minhultimatealien/soccer_robot/Document/Image/Reference/Robocup2018_humanoid final.jpg

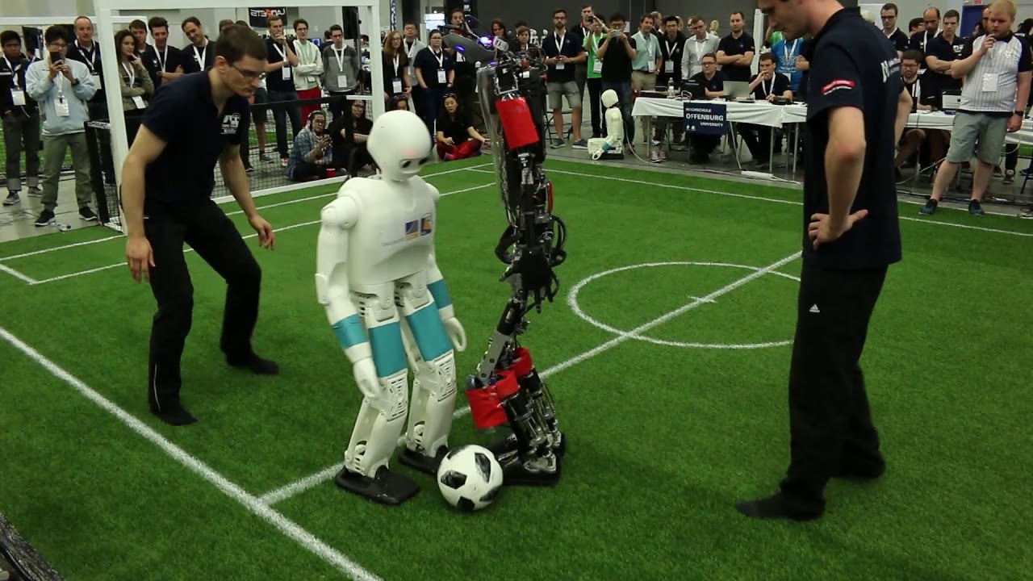
Document/Image/Reference/Robocup2018_humanoid final.jpg
