minhultimatealien/soccer_robot/Document/Image/Pilot/z7851552882575_aa248686b74a95beae13a69e27333dba.jpg

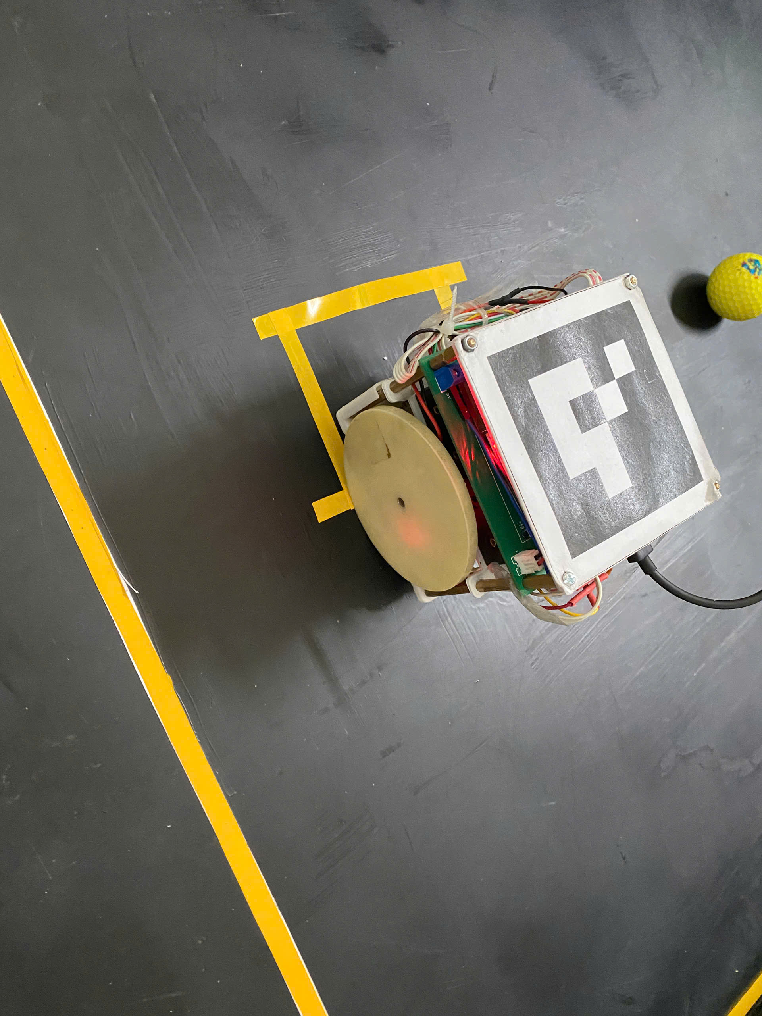
Document/Image/Pilot/z7851552882575_aa248686b74a95beae13a69e27333dba.jpg
