minhultimatealien/soccer_robot/Document/Image/Reference/20210513_170346-2.png

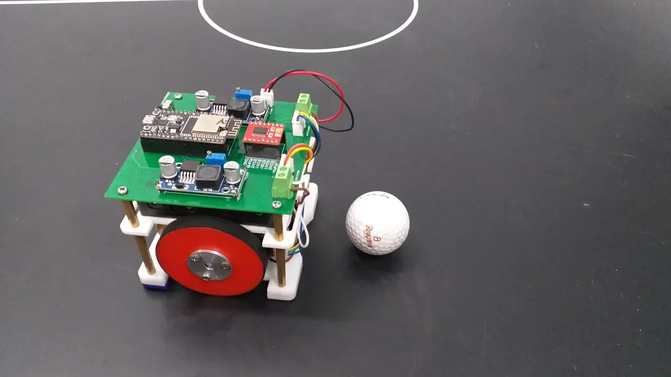
Document/Image/Reference/20210513_170346-2.png
