minhultimatealien/soccer_robot/Document/Image/Reference/Ball Dribbling control.jpg

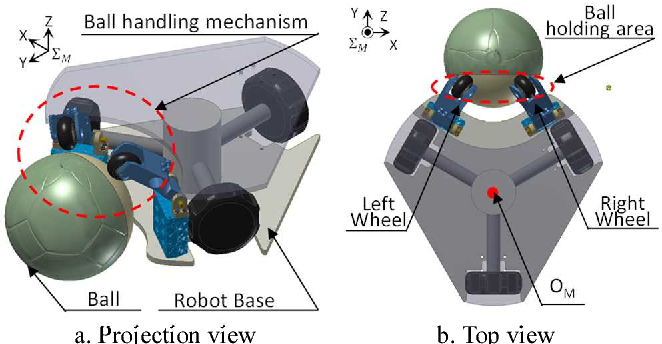
Document/Image/Reference/Ball Dribbling control.jpg
