minhultimatealien/soccer_robot/Document/Image/Reference/beat_worldcup.jpg

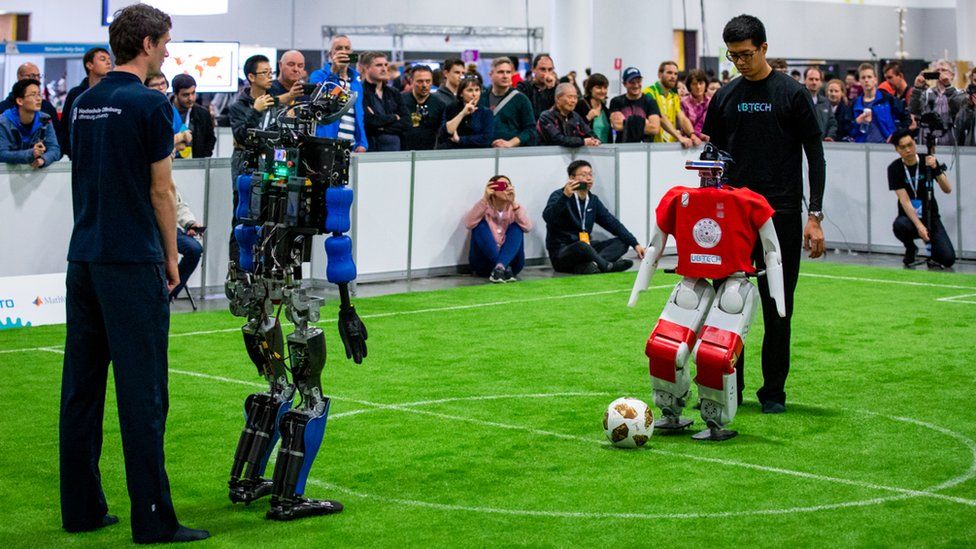
Document/Image/Reference/beat_worldcup.jpg
