minhultimatealien/soccer_robot/Document/Image/Reference/HSV_color_solid_cylinder.png

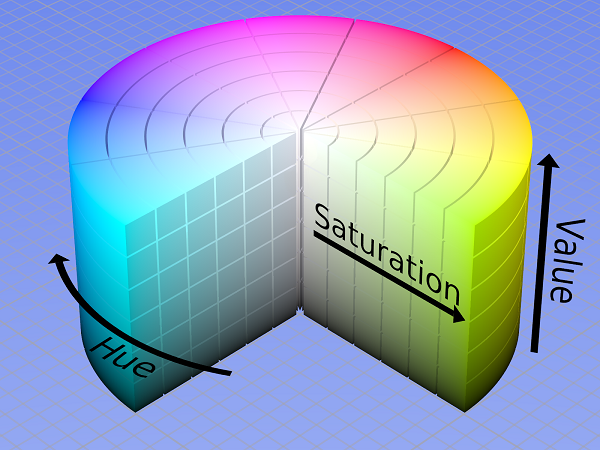
Document/Image/Reference/HSV_color_solid_cylinder.png
