minhultimatealien/soccer_robot/Document/Image/Reference/Kid_size_humanoid.jpg

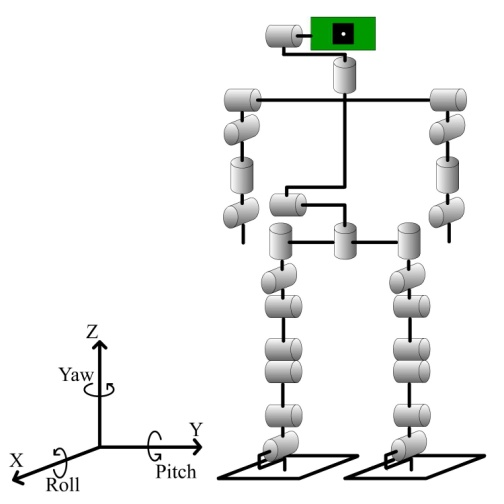
Document/Image/Reference/Kid_size_humanoid.jpg
