minhultimatealien/soccer_robot/Document/Image/Reference/Kidsize_humanoid_league.jpg

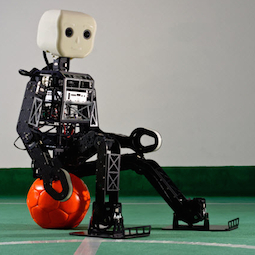
Document/Image/Reference/Kidsize_humanoid_league.jpg
