minhultimatealien/soccer_robot/Document/Image/Reference/machines-08-00029-g007.png

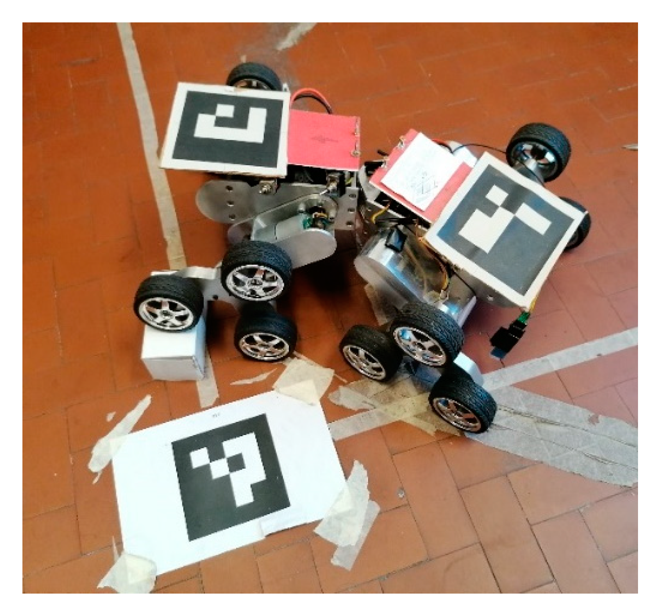
Document/Image/Reference/machines-08-00029-g007.png
