minhultimatealien/soccer_robot/Document/Image/Reference/middle_size_leauge.jpg

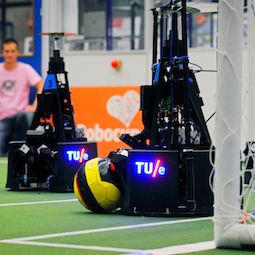
Document/Image/Reference/middle_size_leauge.jpg
