minhultimatealien/soccer_robot/Document/Image/Reference/Omni-Directional Drive.jpg

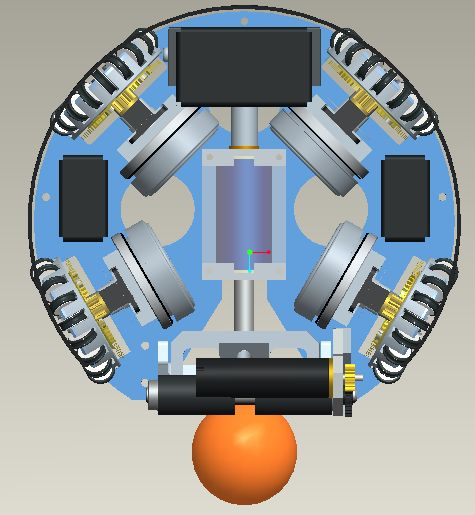
Document/Image/Reference/Omni-Directional Drive.jpg
