minhultimatealien/soccer_robot/Document/Image/Reference/peter stone.jpg

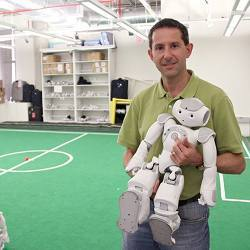
Document/Image/Reference/peter stone.jpg
