minhultimatealien/soccer_robot/Document/Image/Reference/pict1.jpg

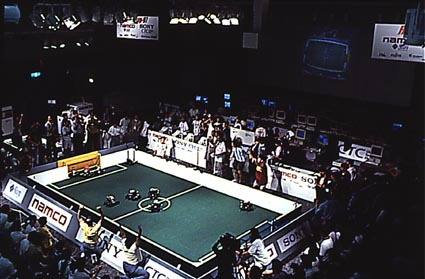
Document/Image/Reference/pict1.jpg
