minhultimatealien/soccer_robot/Document/Image/Reference/Picture1.png

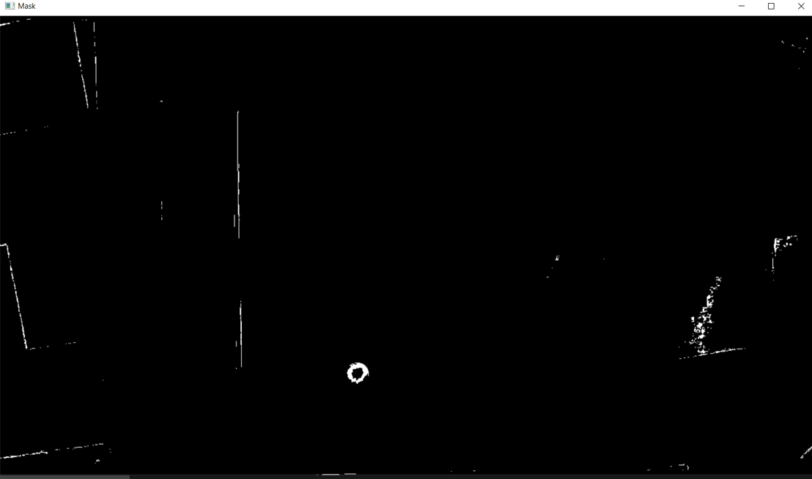
Document/Image/Reference/Picture1.png
