minhultimatealien/soccer_robot/Document/Image/Reference/rescue_robot_league.jpg

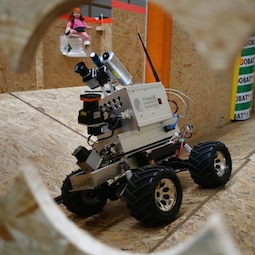
Document/Image/Reference/rescue_robot_league.jpg
