minhultimatealien/soccer_robot/Document/Image/Reference/small_size_league.jpg

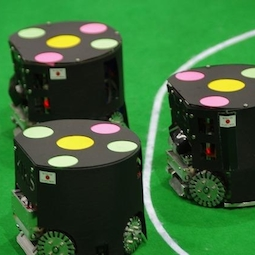
Document/Image/Reference/small_size_league.jpg
