minhultimatealien/soccer_robot/Document/Image/Reference/soccer-robot-system-drawing.png

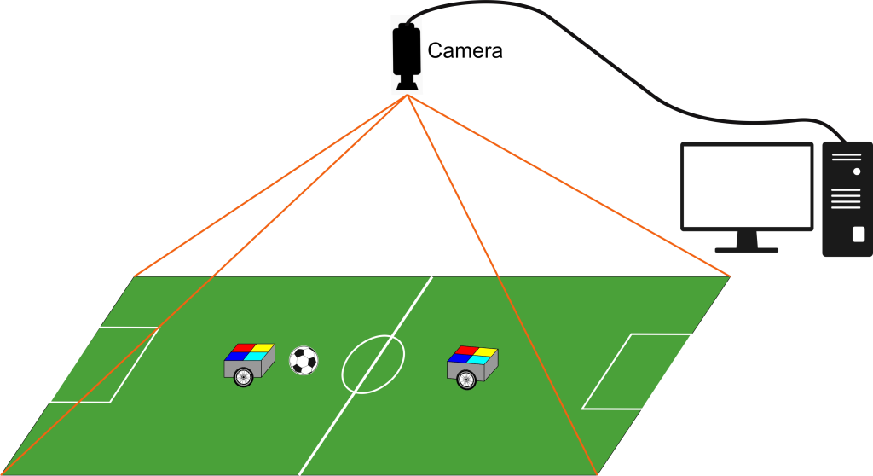
Document/Image/Reference/soccer-robot-system-drawing.png
