minhultimatealien/soccer_robot/Document/Image/Reference/Some-of-the-RoboCup-2006-Humanoid-League-robots.png

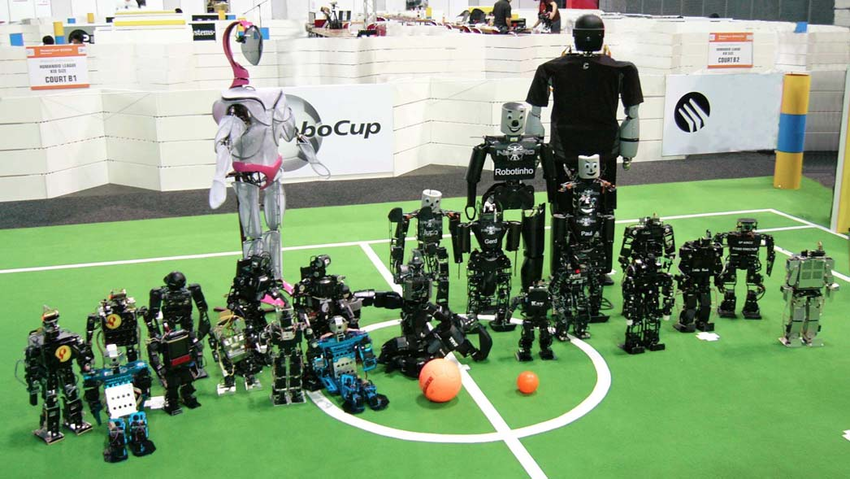
Document/Image/Reference/Some-of-the-RoboCup-2006-Humanoid-League-robots.png
