minhultimatealien/soccer_robot/Document/Image/Reference/The-RoboRoos-kicker-mechanism-In-the-figure-the-striker-is-shown-locked-in-soft-kick.jpg

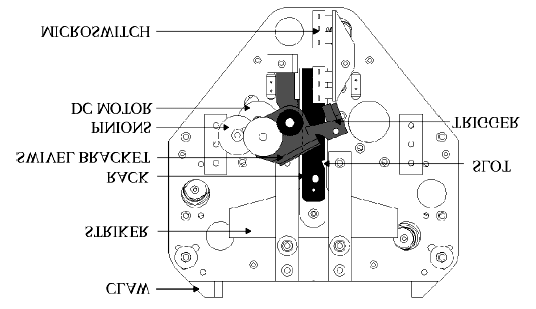
Document/Image/Reference/The-RoboRoos-kicker-mechanism-In-the-figure-the-striker-is-shown-locked-in-soft-kick.jpg
