minhultimatealien/soccer_robot/(list of files, cad)

Other CAD files:
Document/Main document/Principle-selection.dwg
