minhultimatealien/soccer_robot/Document/Main document/Drivengear_fabrication.pdf

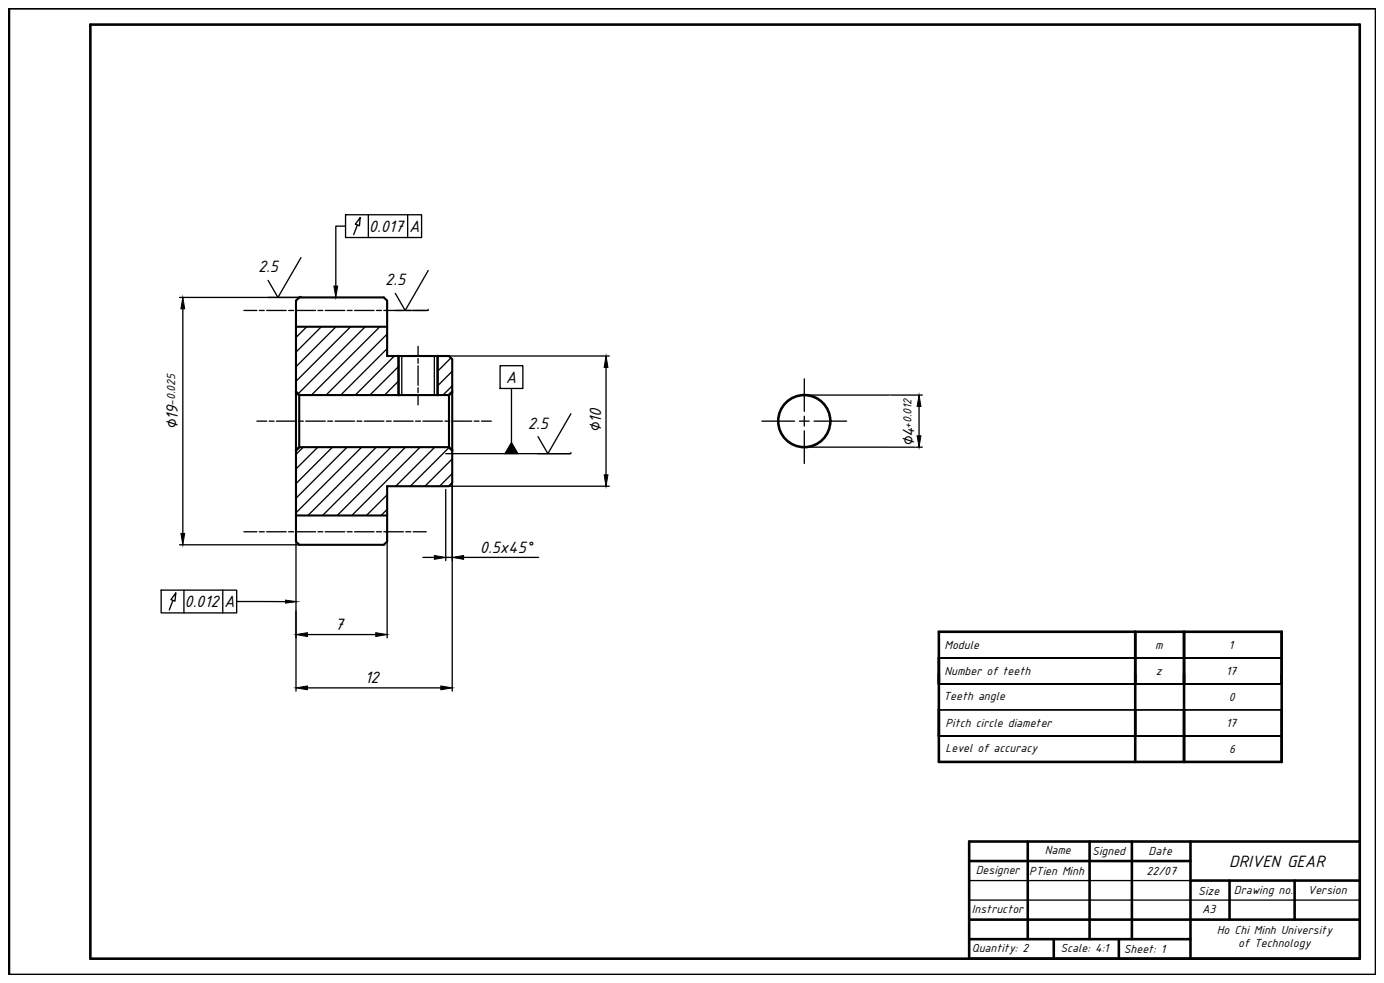
[picture p134: page 1]

∅4+0.012 Number of teeth z 17 Teeth angle 0 Module m 1 Level of accuracy 6 Pitch circle diameter 17 Name Signed Date Designer Instructor Size Drawing no. Version A3 Quantity: 2 Scale: 4:1 Sheet: 1 PTien Minh DRIVEN GEAR Ho Chi Minh University of Technology 22/07
