minhultimatealien/soccer_robot/Document/Main document/Drivinggear_fabrication.pdf

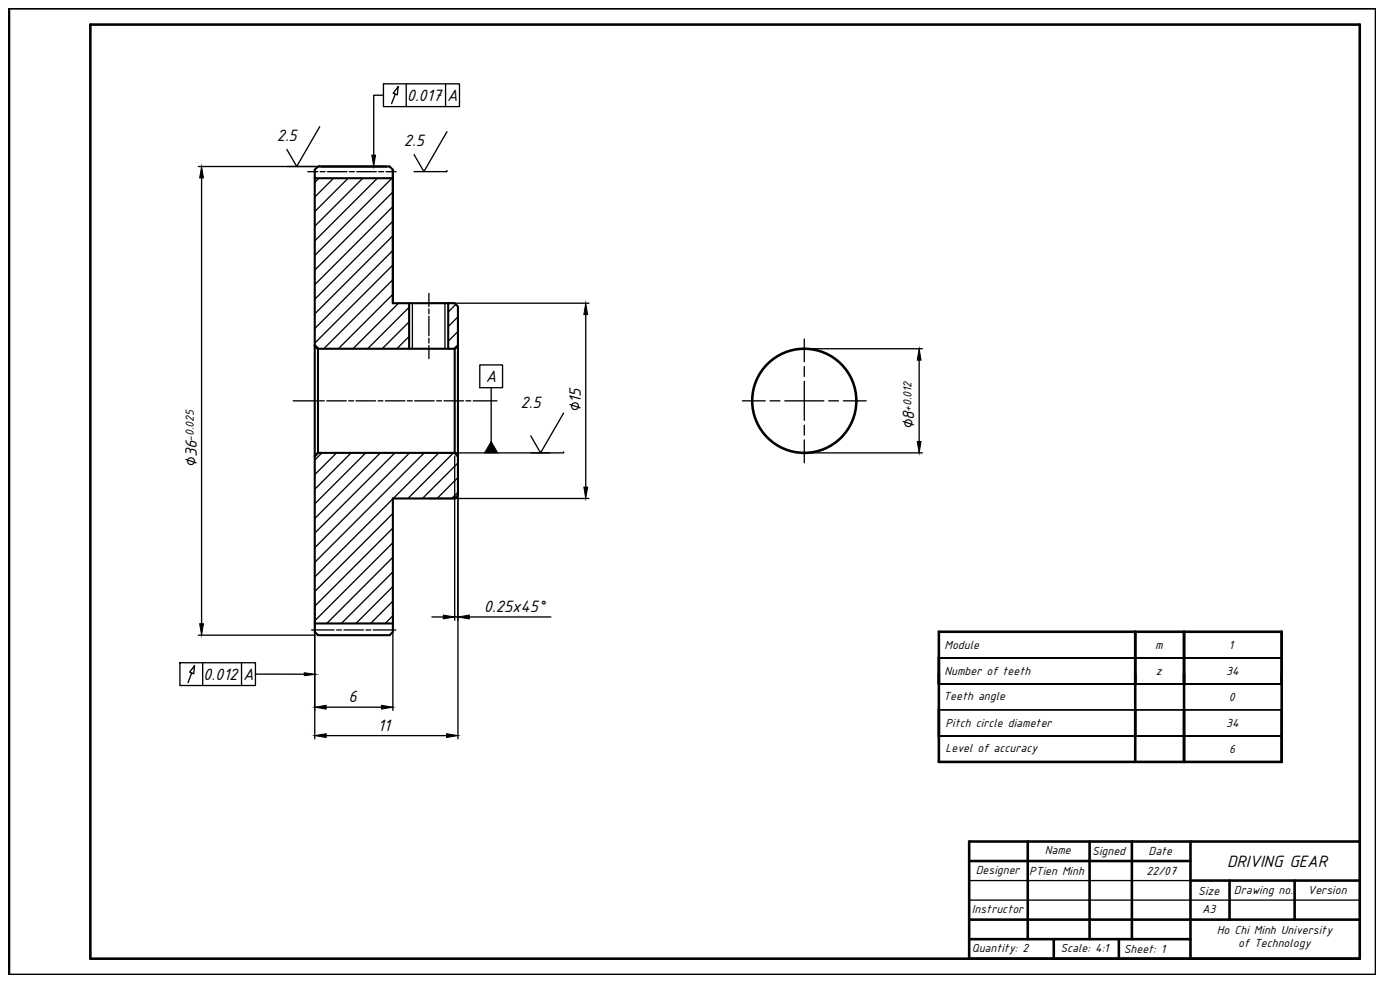
[picture p135: page 1]

∅15 A 2.5 0.017 A 2.5 2.5 Name Signed Date Designer Instructor Size Drawing no. Version A3 Quantity: 2 Scale: 4:1 Sheet: 1 PTien Minh DRIVING GEAR Ho Chi Minh University of Technology 22/07

∅8+0.012 Number of teeth z 34 Teeth angle 0 Module m 1 Level of accuracy 6 Pitch circle diameter 34
