minhultimatealien/soccer_robot/Document/Main document/Mechanical-deisgn.pdf

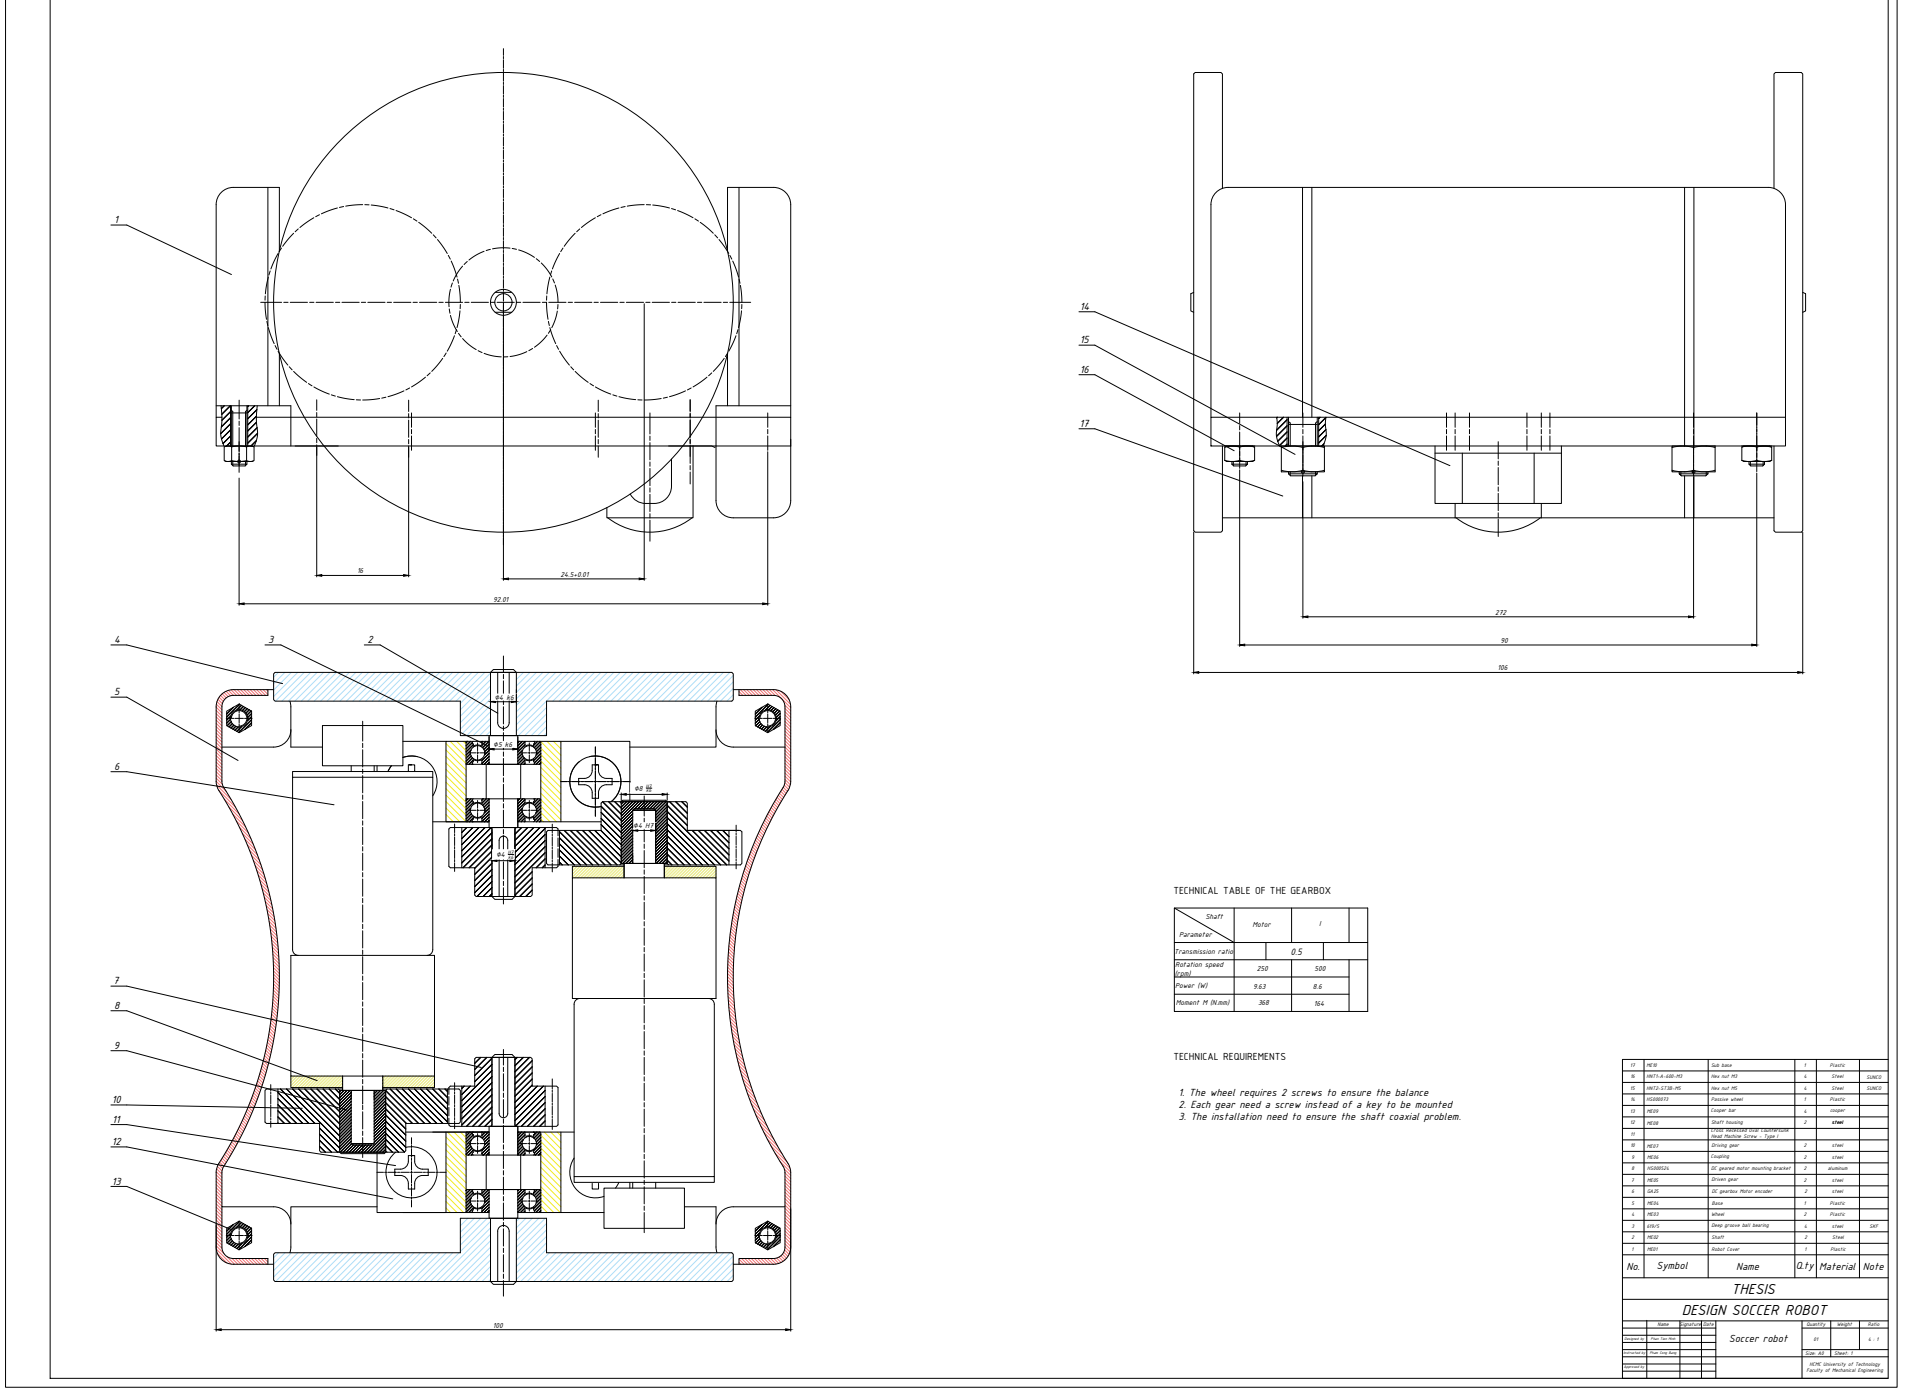
[picture p136: page 1]
Shaft Parameter; Motor; I Transmission ratio Rotation speed (rpm) Power (W); 8.6 TECHNICAL TABLE OF THE GEARBOX 0.5 Moment M (N.mm); 164 TECHNICAL REQUIREMENTS 1. The wheel requires 2 screws to ensure the balance 2. Each gear need a screw instead of a key to be mounted 3. The installation need to ensure the shaft coaxial problem.; THESIS DESIGN SOCCER ROBOT Soccer robot; Quantity; Weight; Ratio 01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
