minhultimatealien/soccer_robot/Document/Main document/Mechanical-design.pdf

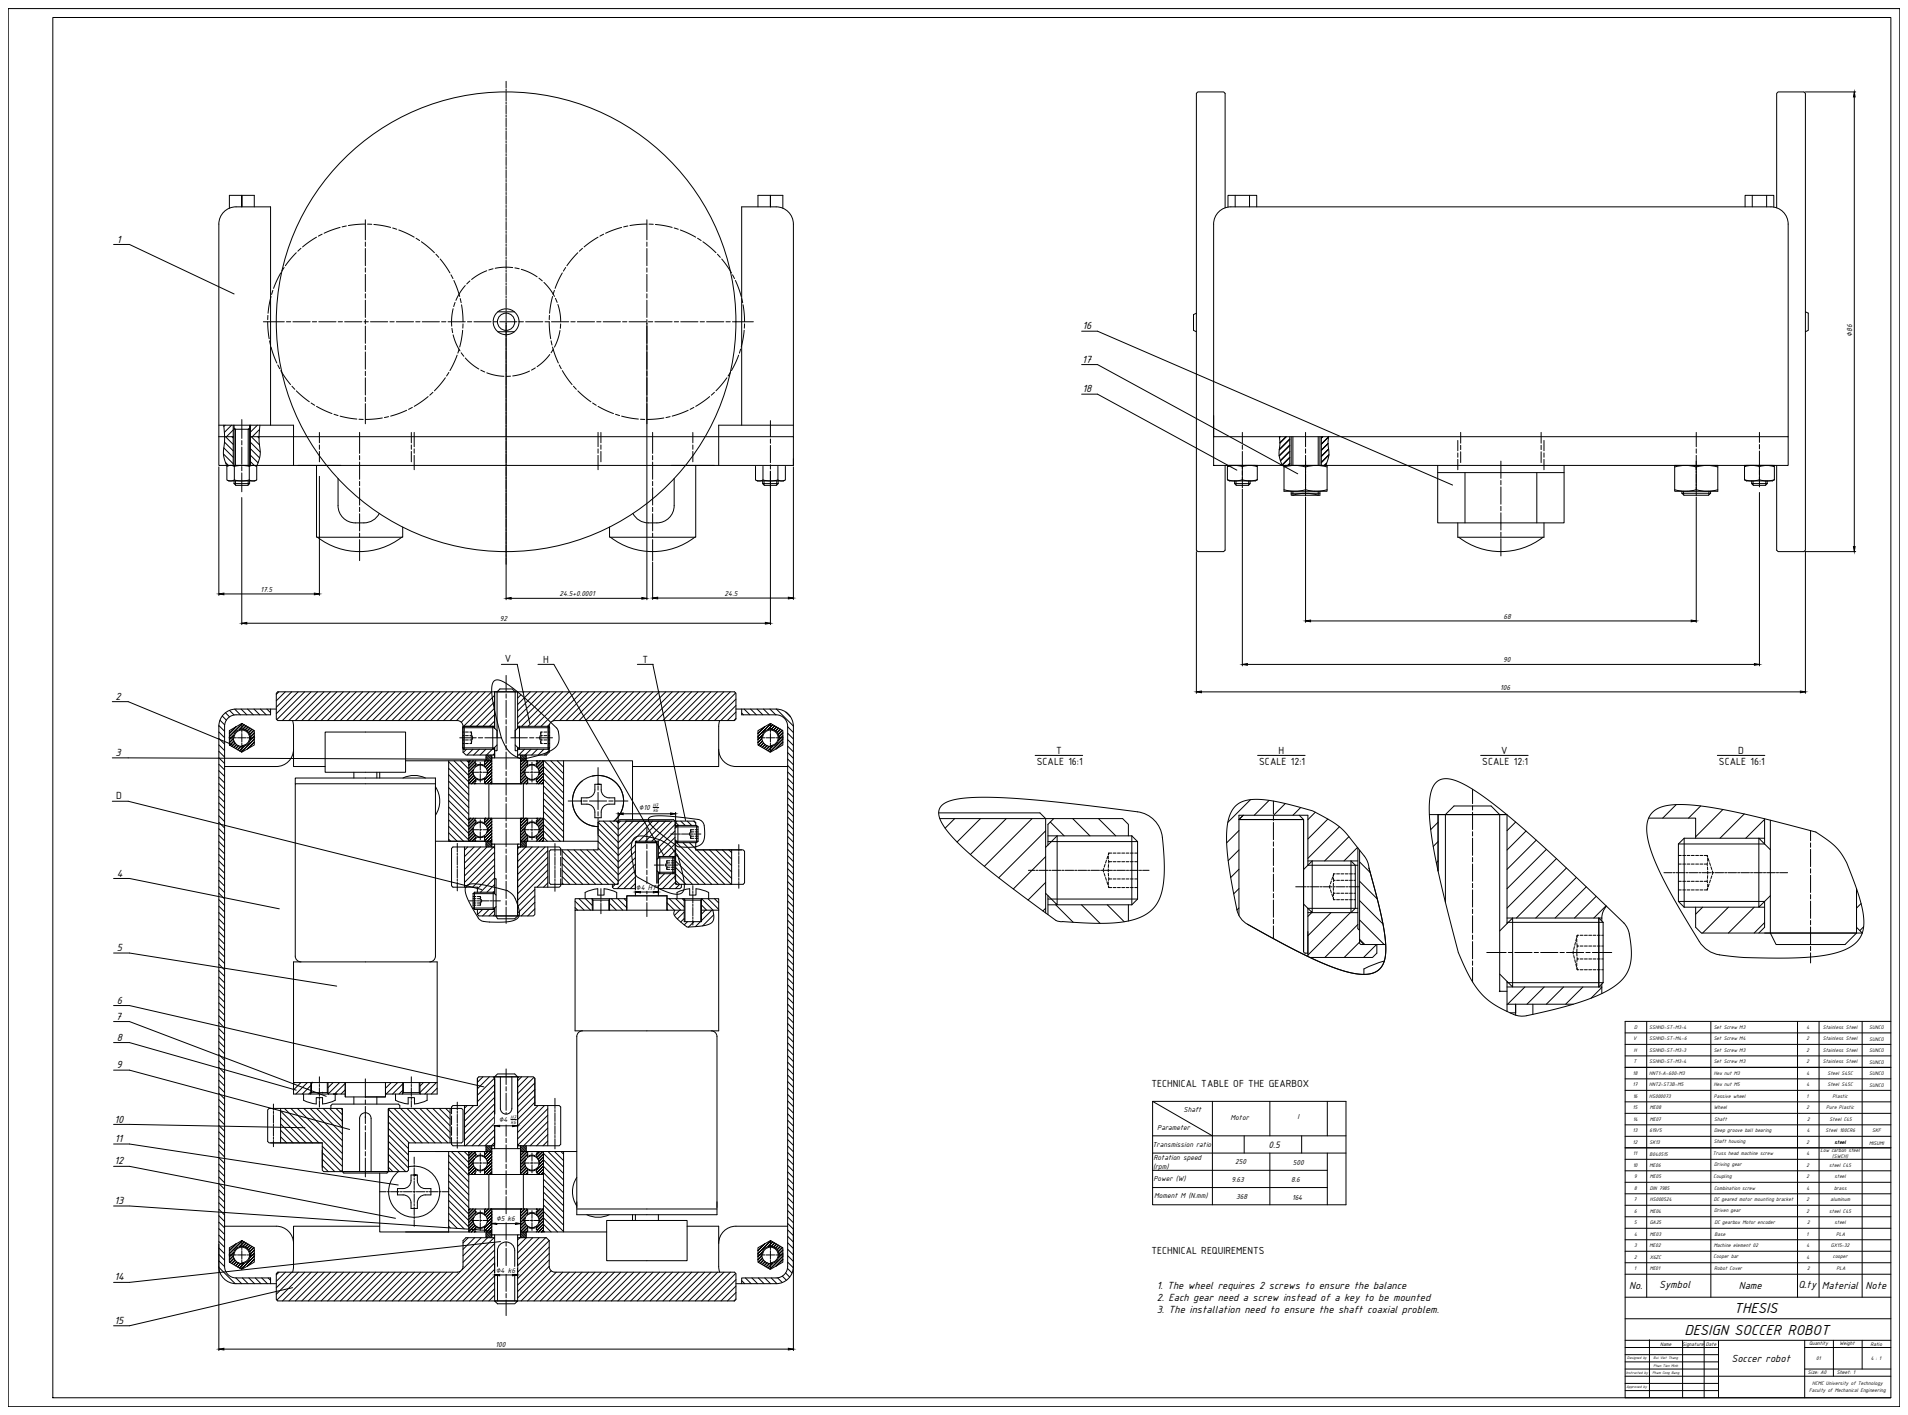
[picture p137: page 1]

∅86 3 3 ME02 Machine element 02 4 GX15-32 12D 8 DIN 7985 Combination screw 4 brass B040515 Truss head machine screw Low carbon steel (SWCH) Stainless Steel Stainless Steel Stainless Steel Steel S45C 24.5 X6ZC SK13 MISUMI Phan Tien Minh
