minhultimatealien/soccer_robot/Document/Main document/Shaft_fabrication.pdf

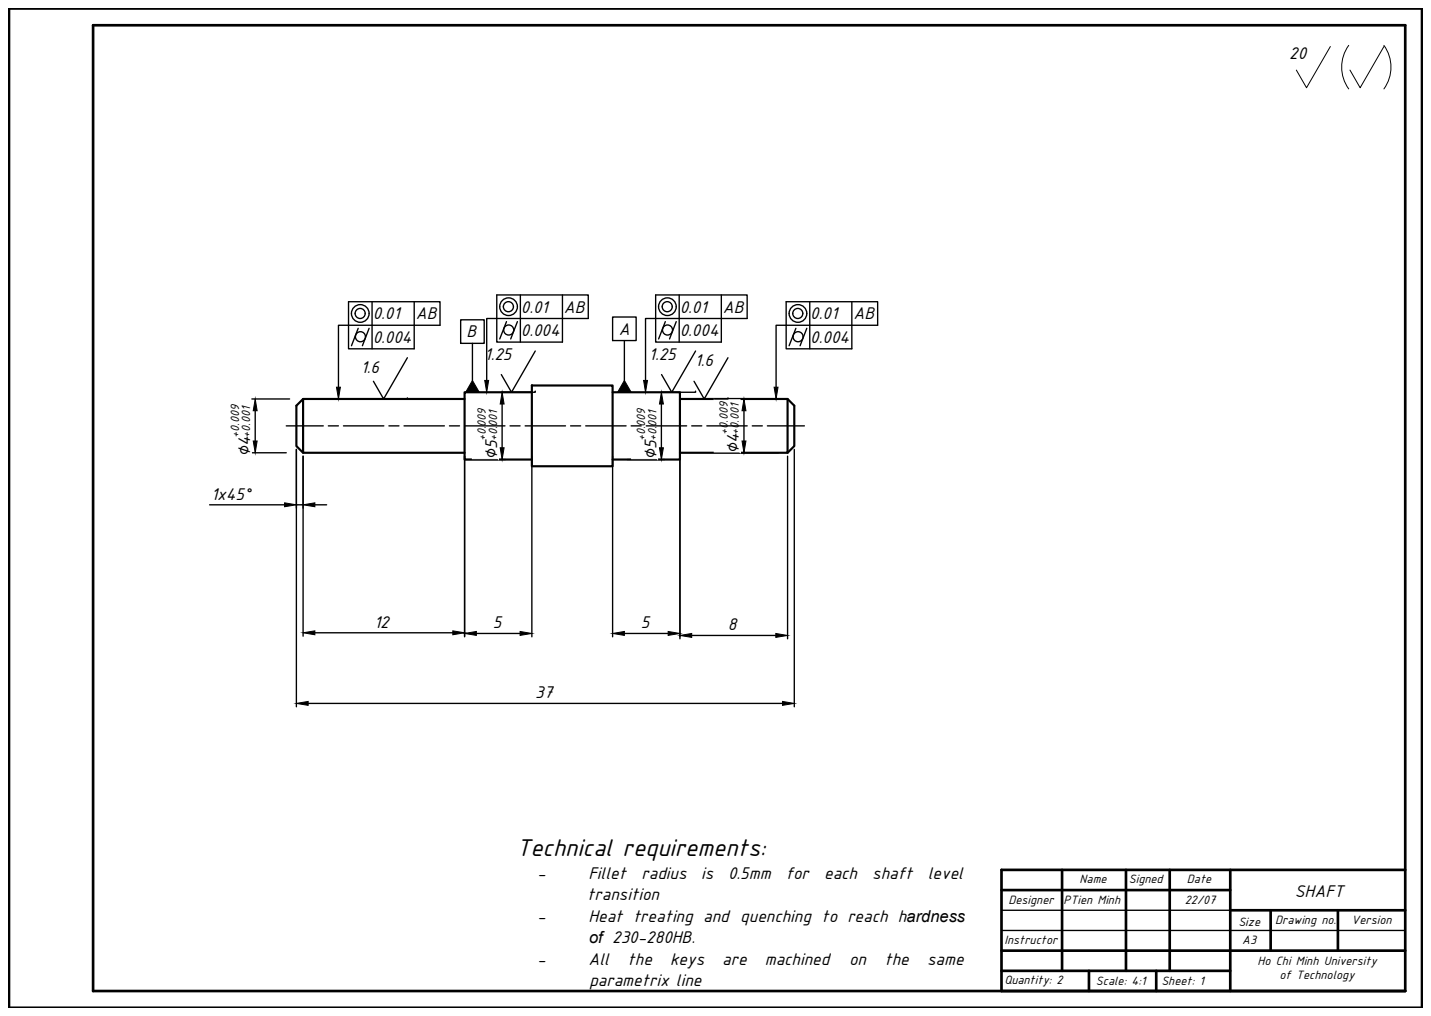
[picture p138: page 1]

+0.001 1x45° 1.6 1.6 1.25 1.25 20 Name Signed Date Designer Instructor Size Drawing no. Version A3 Quantity: 2 Scale: 4:1 Sheet: 1 PTien Minh SHAFT Ho Chi Minh University of Technology 22/07 Technical requirements: - Fillet radius is 0.5mm for each shaft level transition - Heat treating and quenching to reach hardness of 230-280HB. - All the keys are machined on the same parametrix line
