minhultimatealien/soccer_robot/Document/Main document/Figure_driver_block.pdf

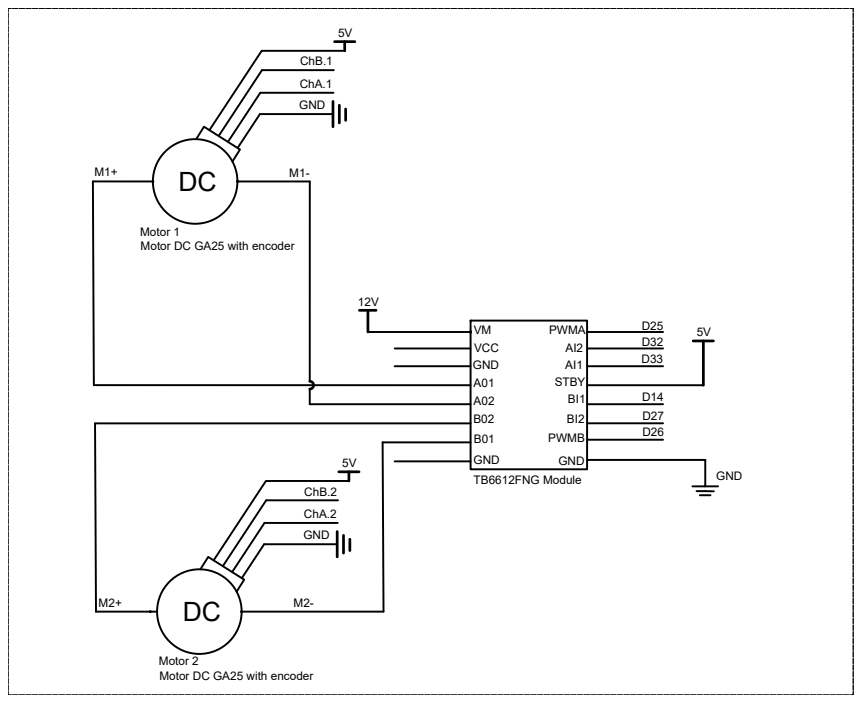
[picture p139: page 1]
TB6612FNG Module

Motor 1
Motor DC GA25 with encoder

Motor 2
