minhultimatealien/soccer_robot/Document/Main document/Robot_control_algorithm.pdf

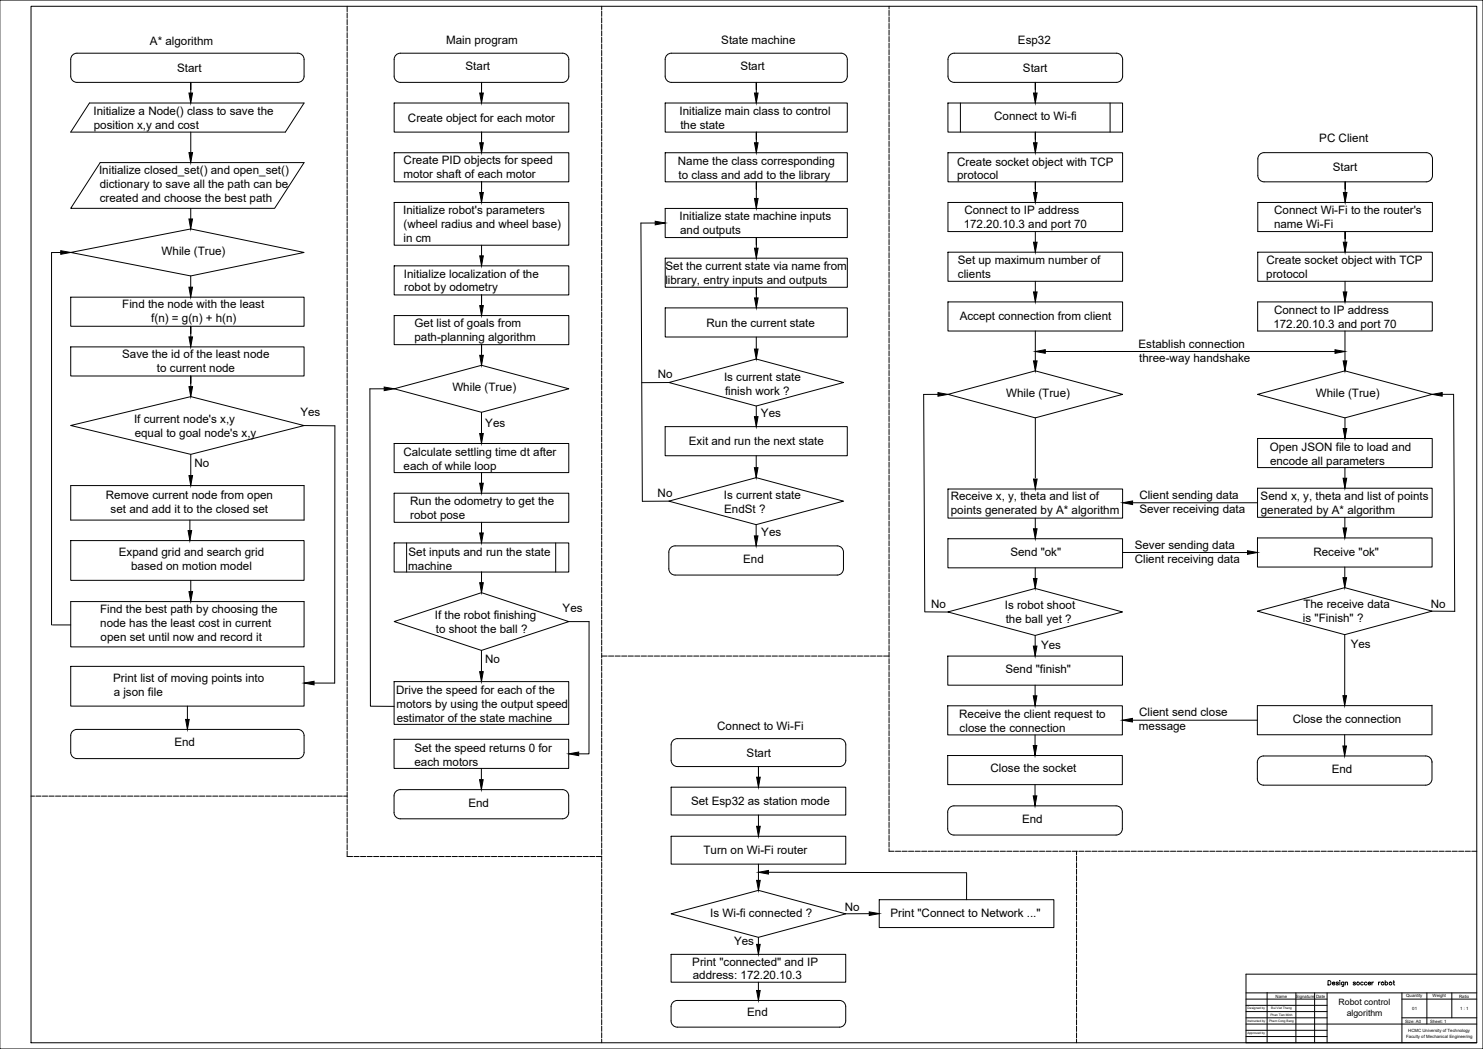
[picture p140: page 1]
Robot control algorithm; Quantity; Weight; Ratio 01; 1 : 1 Sheet: 1 HCMC University of Technology Faculty of Mechanical Engineering Designed by Instructed by Approved by; Name; Signature; Date Bui Viet Thang Pham Cong Bang; Size: A0 Initialize a Node() class to save the position x,y and cost Start While (True) Find the node with the least f(n) = g(n) + h(n) Remove current node from open set and add it to the closed set If current node's x,y equal to goal node's x,y No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
