minhultimatealien/soccer_robot/Document/Main document/Electrical-design.pdf

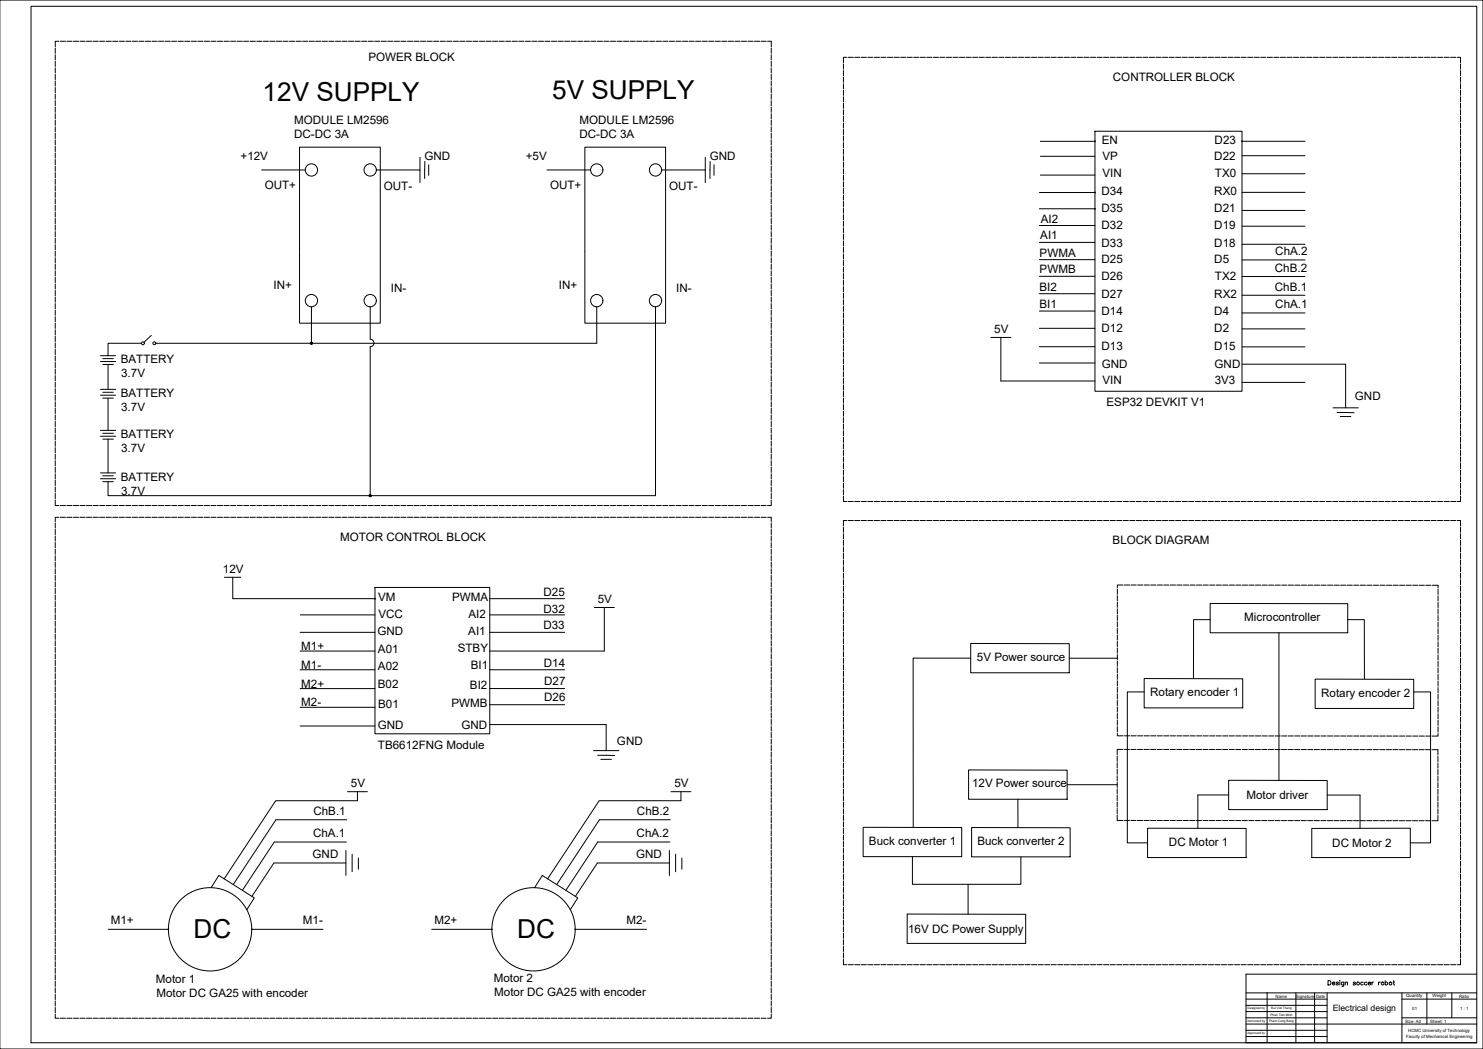
[picture p141: page 1]
