minhultimatealien/soccer_robot/Document/Main document/Principle-selection-Model.pdf

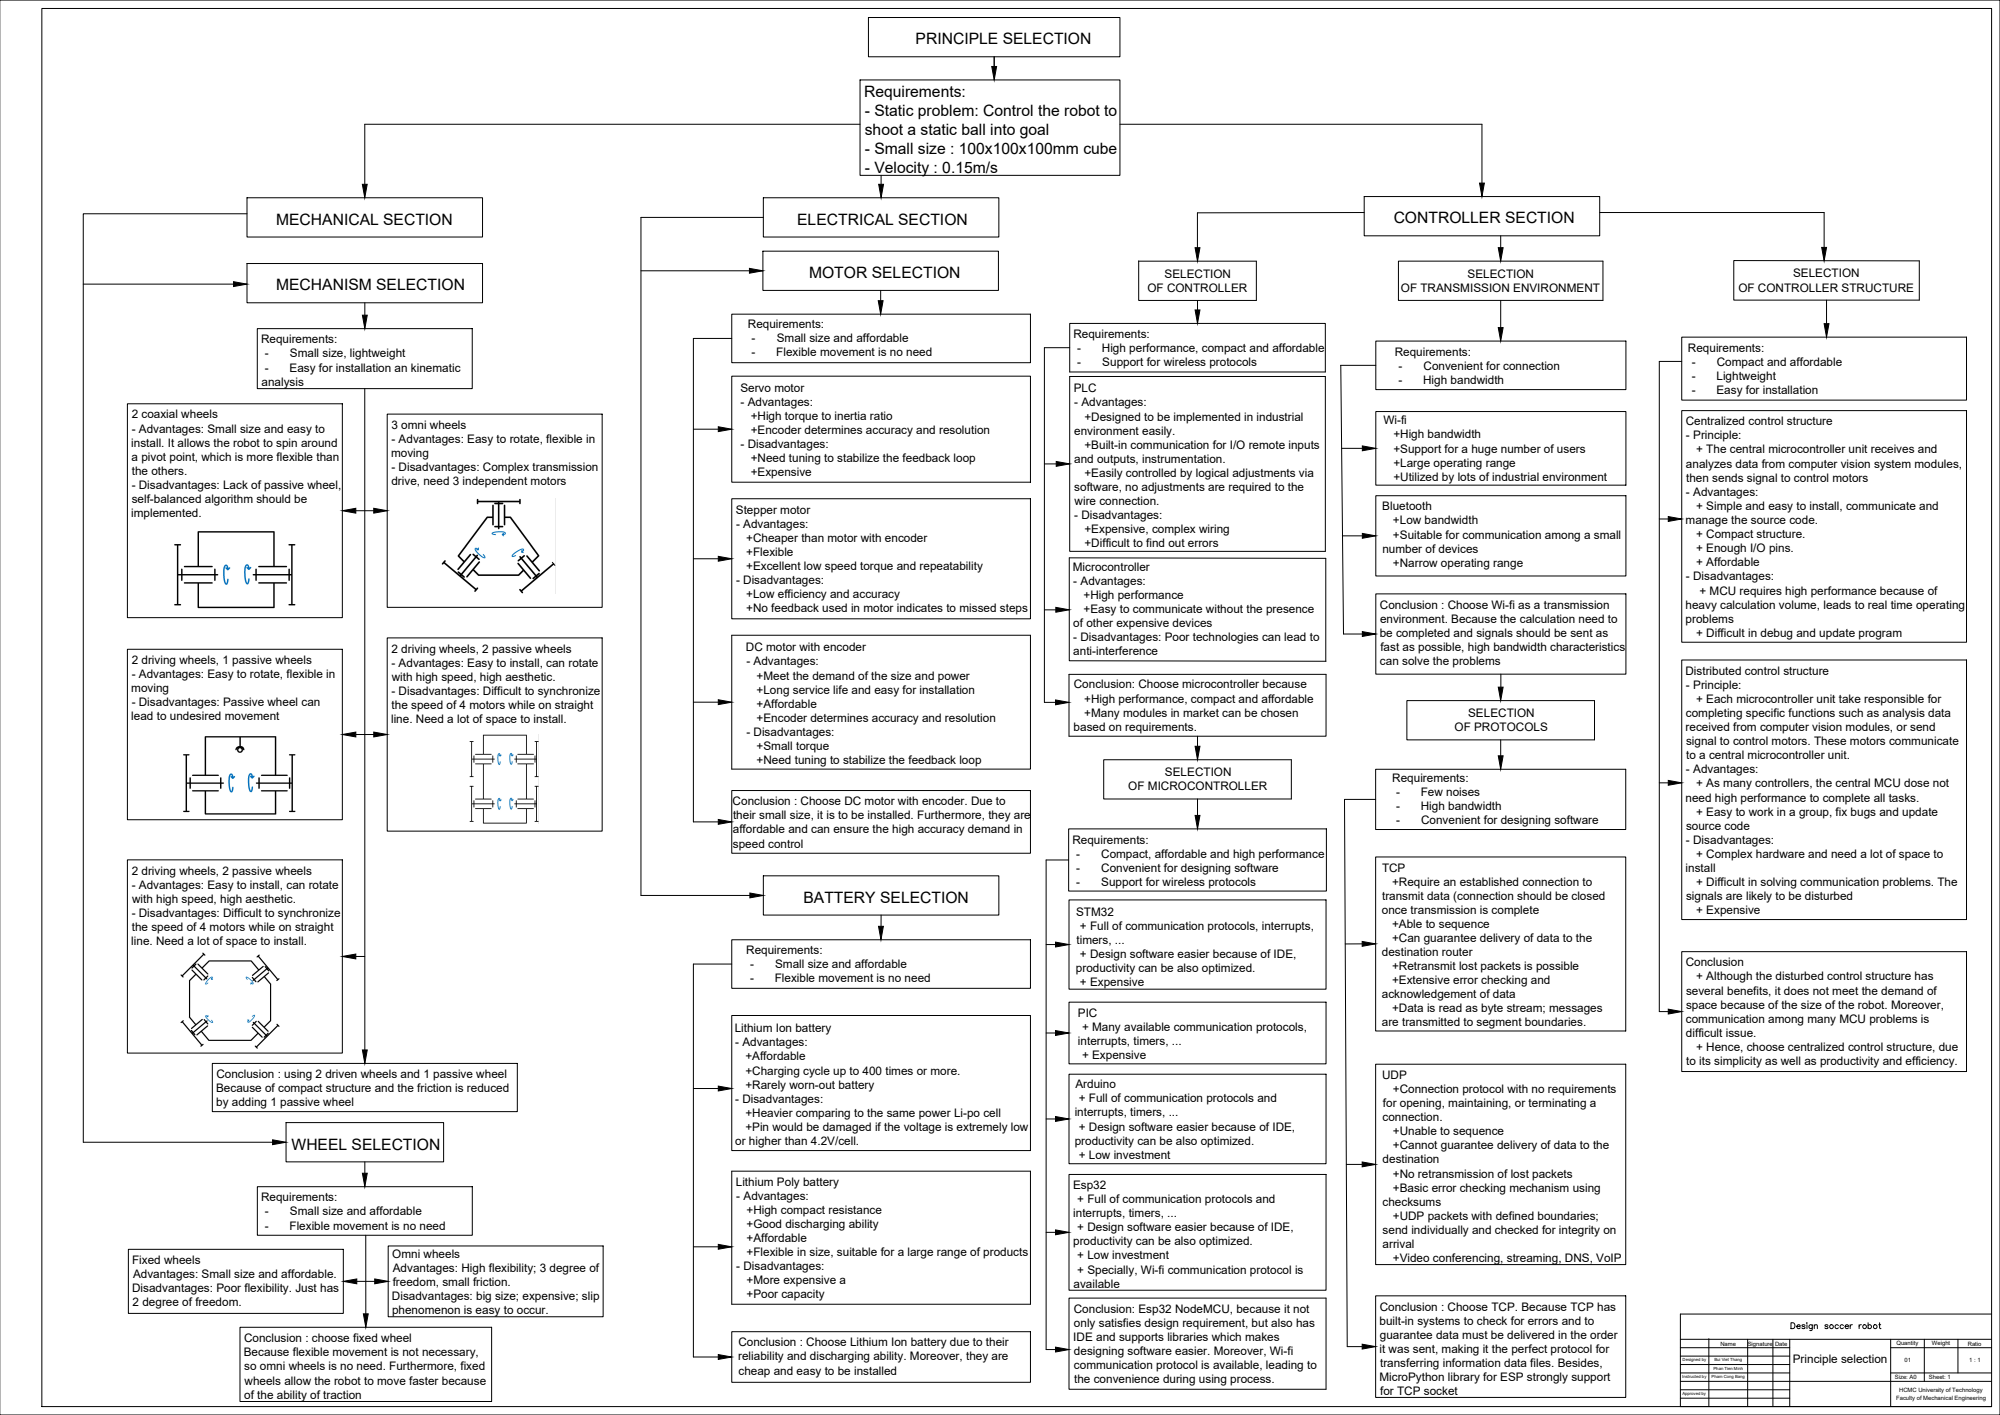
[picture p142: page 1]
Principle selection; Quantity; Weight; Ratio 01; 1 : 1 Sheet: 1 HCMC University of Technology Faculty of Mechanical Engineering Designed by Instructed by Approved by; Name; Signature; Date Bui Viet Thang Pham Cong Bang; Size: A0 PRINCIPLE SELECTION MECHANICAL SECTION; ELECTRICAL SECTION Requirements: - Static problem: Control the robot to shoot a static ball into goal - Small size : 100x100x100mm cube - Velocity : 0.15m/s; CONTROLLER SECTION SELECTION OF CONTROLLER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

- Easy for installation Phan Tien Minh

- Convenient for designing software
